vieuxsinge/kegwasher/(threads)

Thread 2 (2019-06-27):

Welldone ! => Peut-on avoir la liste des courses ?

conidelb, 2019-06-27:
Canon les gars ! On va s'en faire une... Hâte d'avoir la liste des courses :-)

fredericsureau, 2019-10-18:
Hello !
Je viens de l'ajouter !
En fait ça nous a coûté moins de 1 500 € HT si on exclut le compresseur
Bon courage à vous

Closed 2019-10-18.

Thread 3 (2019-07-05):

Ajout d’une licence

kdltr, 2019-07-05:
Y’a pas de licence pour la chose ?
Voilà un petit guide sur comment faire, au cas où. :)

https://www.gnu.org/licenses/gpl-howto.fr.html

fredericsureau, 2019-10-18:
C'est fait !
GPLv3 pour info.
Merci du retour

Closed 2019-10-18.

Thread 6 (2020-06-19):

problem with char*

sjavierdu, 2020-06-19:
Hi, I like your project, I bought all parts and try to replicate with some differences: valve 24vdc andtwo types of alimentation: 12vdc(arduino) and 24vdc (valves)

Now I want to take the project to a breadboard but when I try to compile the file these errors appear in kegwasher file:

```
\kegwasher.ino:141:1: warning: ISO C++ forbids converting a string constant to 'char*' [-Wwrite-strings]
 };
 ^
\kegwasher.ino:141:1: warning: ISO C++ forbids converting a string constant to 'char*' [-Wwrite-strings]
\kegwasher.ino:141:1: warning: ISO C++ forbids converting a string constant to 'char*' [-Wwrite-strings]
\kegwasher.ino:141:1: warning: ISO C++ forbids converting a string constant to 'char*' [-Wwrite-strings]
\kegwasher.ino:141:1: warning: ISO C++ forbids converting a string constant to 'char*' [-Wwrite-strings]
\kegwasher.ino:141:1: warning: ISO C++ forbids converting a string constant to 'char*' [-Wwrite-strings]
\kegwasher.ino:141:1: warning: ISO C++ forbids converting a string constant to 'char*' [-Wwrite-strings]
\kegwasher.ino:141:1: warning: ISO C++ forbids converting a string constant to 'char*' [-Wwrite-strings]
\kegwasher.ino:141:1: warning: ISO C++ forbids converting a string constant to 'char*' [-Wwrite-strings]
\kegwasher.ino: In function 'void select()':
\kegwasher.ino:201:22: warning: ISO C++ forbids converting a string constant to 'char*' [-Wwrite-strings]
   lcd_printf("Mode :");
                      ^
\kegwasher.ino:203:53: warning: ISO C++ forbids converting a string constant to 'char*' [-Wwrite-strings]
   lcd_printf("%c %s", CHAR_UP_DOWN, MODES[mode].name);
                                                     ^
\kegwasher.ino: In function 'void select_update()':
\kegwasher.ino:237:55: warning: ISO C++ forbids converting a string constant to 'char*' [-Wwrite-strings]
     lcd_printf("%c %s", CHAR_UP_DOWN, MODES[mode].name);
                                                       ^
\kegwasher.ino: In function 'void run()':
\kegwasher.ino:311:27: warning: ISO C++ forbids converting a string constant to 'char*' [-Wwrite-strings]
   lcd_printf("Preparation");
                           ^
\kegwasher.ino: In function 'void run_update()':
\kegwasher.ino:354:74: warning: ISO C++ forbids converting a string constant to 'char*' [-Wwrite-strings]
   lcd_printf(" %dmn%02d / %dmn%02d", rtime_mn, rtime_s, ftime_mn, ftime_s);
                                                                          ^
\kegwasher.ino: In function 'void terminate()':
\kegwasher.ino:372:24: warning: ISO C++ forbids converting a string constant to 'char*' [-Wwrite-strings]
   lcd_printf(" Termine");
                        ^
\kegwasher.ino: In function 'void cancel()':
\kegwasher.ino:389:23: warning: ISO C++ forbids converting a string constant to 'char*' [-Wwrite-strings]
   lcd_printf(" Annule");
                       ^
El Sketch usa 8512 bytes (26%) del espacio de almacenamiento de programa. El máximo es 32256 bytes.
Las variables Globales usan 768 bytes (37%) de la memoria dinámica, dejando 1280 bytes para las variables locales. El máximo es 2048 bytes.
`

```

`thank` a lot
Javier

sjavierdu, 2020-06-21:
really, no afect the proccess this warning, but the solution is add "const" :

void lcd_printf(const char *fmt, ...)

fredericsureau, 2020-06-23:
Hi sjavierdu,

Thanks for the feedback!
I am using the Arduino environment and I think that nearly all warnings are masked.

Regards

Closed 2020-06-21.

Thread 7 (2020-06-20):

Relai Pompe

blurp1478963, 2020-06-20:
Bonjour,

En étudiant un peu le cablage sur les photos, je ne vois pas de relai pour la pompe, est-elle directement branchée en 220 sur la carte relai ?

Merci!

sjavierdu, 2020-06-22:
Hi, the relay support máx: 10A/250VAC, 10A/30VDC, I think is enough for the pump.
if that pump were higher amperage you would need another relay on the way

sjavierdu, 2020-06-23:
I think channel 9 of the relay is not used for the pump and is replaced by an ssr relay, but @fredericsureau say in other hand that he buy a 16 channel relay for this.

look! this video show as how to add a second contactor (in our case relay) in your relay optocoupler. I believe it not the case: https://www.youtube.com/watch?v=wGYn83sksgE&t=564s
Maybe it helps a little, I didn't know the second ssr relay, I don't see it in the material list (maybe it's a change on the go, )

merci!
merci!

fredericsureau, 2020-06-23:
Oui c'est bien le relai n°9 qui est utilisé directement pour activer la pompe.
Les relais supportent 220VAC/10A ce qui est suffisant pour une petite pompe comme la Novax.

En regardant sur la photo, tu vois un cable marron qui court le long de la carte des relais sur la gauche.
C'est le fil de phase de la pompe.

Bon courage !

fredericsureau, 2020-06-23:
@sjavierdu The SSR relay is used for the heating element. The pump is directly actionned by the relay n° 9.

blurp1478963, 2020-06-23:
Merci! Nous avons presque fini notre laveuse! Nous avons qq input à filer pour contribuer dès qu'elle sera en marche!

Closed 2020-06-23.

Thread 8 (2020-06-21):

remains of peracetic in keg and lack of pressurization

sjavierdu, 2020-06-21:
1- I have found that the program does not leave the keg pressurized at the end of the cycle, this option is correct to avoid foaming when filling due to pressure difference
solution: I have added a washing option in the menu with and without adding co2 for pressurization

2-The peracetic, if used as a desinfectant, is very oxidizing and damages the hop aroma in highly hopped beers, in addition to increasing the level of dissolved oxygen.
solution: A moderately used practice, is after the washing cycle, leave kegs inverted until use the next day, very carefully add it to the kegwasher, do a small purge (it really removes peracetic) and do a new pressurization.

I create the menu in spanish, but only changue the words.
`#include <stdarg.h>
#include <EEPROM.h>
#include <Bounce2.h>
#include <Wire.h>
#include <LiquidCrystal_I2C.h>

#define PIN_BUZZER                A0
#define PIN_BUTTON_UP             A1
#define PIN_BUTTON_DOWN           A2
#define PIN_BUTTON_ACTION         A3
#define PIN_VALVE_AIR             2
#define PIN_VALVE_CO2             3
#define PIN_VALVE_WATER           4
#define PIN_VALVE_CLEANER_IN      5
#define PIN_VALVE_SANITIZER_IN    6
#define PIN_VALVE_CLEANER_OUT     7
#define PIN_VALVE_SANITIZER_OUT   8
#define PIN_VALVE_DRAIN           9
#define PIN_PUMP                  10
#define PIN_LED                   11

#define DISPLAY_I2C_ADDRESS       0x27

#define CTRL_WATER          0b000000001
#define CTRL_CLEANER_IN     0b000000010
#define CTRL_SANITIZER_IN   0b000000100
#define CTRL_AIR            0b000001000
#define CTRL_CO2            0b000010000
#define CTRL_DRAIN          0b000100000
#define CTRL_CLEANER_OUT    0b001000000
#define CTRL_SANITIZER_OUT  0b010000000
#define CTRL_PUMP           0b100000000

#define CONFIG_DRAIN            (CTRL_DRAIN)
#define CONFIG_DRAIN_SANITIZER  (CTRL_PUMP + CTRL_SANITIZER_IN + CTRL_DRAIN)
#define CONFIG_DRAIN_CLEANER    (CTRL_PUMP + CTRL_CLEANER_IN + CTRL_DRAIN)
#define CONFIG_FILL_SANITIZER   (CTRL_PUMP + CTRL_SANITIZER_OUT + CTRL_WATER)
#define CONFIG_FILL_CLEANER     (CTRL_PUMP + CTRL_CLEANER_OUT + CTRL_WATER)
#define CONFIG_RINCE            (CTRL_PUMP + CTRL_WATER + CTRL_DRAIN)
#define CONFIG_RINCE_PURGE      (CTRL_AIR + CTRL_DRAIN)
#define CONFIG_RINCE_PURGE_CO2  (CTRL_CO2 + CTRL_DRAIN)
#define CONFIG_CLEAN            (CTRL_PUMP + CTRL_CLEANER_IN + CTRL_CLEANER_OUT)
#define CONFIG_CLEAN_PURGE      (CTRL_AIR + CTRL_CLEANER_OUT)
#define CONFIG_SANITIZE         (CTRL_PUMP + CTRL_SANITIZER_IN + CTRL_SANITIZER_OUT)
#define CONFIG_SANITIZE_PURGE   (CTRL_AIR + CTRL_SANITIZER_OUT)
#define CONFIG_END              0
#define CONFIG_FILL_CO2         (CTRL_CO2)                     //add
#define LED_BLINK_PERIOD    2

typedef struct step_s {
  unsigned int config;
  int duration;
} step_t;

typedef struct mode_s {
  char *name;
  step_t *steps;
} mode_t;

step_t STEPS_WASH_KEG_CCO2[] = {                    //add  -    con co2 -with co2
  {CONFIG_DRAIN, 10},
  {CONFIG_RINCE, 10},
  {CONFIG_RINCE_PURGE, 20},
  {CONFIG_CLEAN, 10},
  {CONFIG_CLEAN_PURGE, 15},
  {CONFIG_CLEAN, 10},
  {CONFIG_CLEAN_PURGE, 15},
  {CONFIG_CLEAN, 10},
  {CONFIG_CLEAN_PURGE, 20},
  {CONFIG_RINCE, 3},
  {CONFIG_RINCE_PURGE, 10},
  {CONFIG_RINCE, 7},
  {CONFIG_RINCE_PURGE, 10},
  {CONFIG_RINCE, 10},
  {CONFIG_RINCE_PURGE, 20},
  {CONFIG_SANITIZE, 10},
  {CONFIG_SANITIZE_PURGE, 15},
  {CONFIG_SANITIZE, 10},
  {CONFIG_SANITIZE_PURGE, 15},
  {CONFIG_SANITIZE, 10},
  {CONFIG_SANITIZE_PURGE, 20},
  {CONFIG_RINCE, 10},
  {CONFIG_RINCE_PURGE_CO2, 30},
  {CONFIG_FILL_CO2, 10},
  {CONFIG_END, 0}
};

step_t STEPS_WASH_KEG_SCO2[] = {                       //sin co2  - without co2
  {CONFIG_DRAIN, 10},
  {CONFIG_RINCE, 10},
  {CONFIG_RINCE_PURGE, 20},
  {CONFIG_CLEAN, 10},
  {CONFIG_CLEAN_PURGE, 15},
  {CONFIG_CLEAN, 10},
  {CONFIG_CLEAN_PURGE, 15},
  {CONFIG_CLEAN, 10},
  {CONFIG_CLEAN_PURGE, 20},
  {CONFIG_RINCE, 3},
  {CONFIG_RINCE_PURGE, 10},
  {CONFIG_RINCE, 7},
  {CONFIG_RINCE_PURGE, 10},
  {CONFIG_RINCE, 10},
  {CONFIG_RINCE_PURGE, 20},
  {CONFIG_SANITIZE, 10},
  {CONFIG_SANITIZE_PURGE, 15},
  {CONFIG_SANITIZE, 10},
  {CONFIG_SANITIZE_PURGE, 15},
  {CONFIG_SANITIZE, 10},
  {CONFIG_SANITIZE_PURGE, 20},
  {CONFIG_RINCE, 10},
  {CONFIG_RINCE_PURGE_CO2, 30},
    {CONFIG_END, 0}
};

step_t STEPS_DRAFT_RINCE[] = {
  {CONFIG_RINCE, 30},
  {CONFIG_RINCE_PURGE, 10},
  {CONFIG_END, 0}
};

step_t STEPS_DRAFT_SANITIZER[] = {
  {CONFIG_SANITIZE, 30},
  {CONFIG_SANITIZE_PURGE, 10},
  {CONFIG_END, 0}
};

step_t STEPS_DRAFT_CLEANER[] = {
  {CONFIG_CLEAN, 30},
  {CONFIG_CLEAN_PURGE, 10},
  {CONFIG_END, 0}
};

step_t STEPS_DRAIN_KEG[] = {
  {CONFIG_DRAIN, 10},
  {CONFIG_RINCE_PURGE, 60},
  {CONFIG_END, 0}
};

step_t STEPS_DRAIN_SANITIZER[] = {
  {CONFIG_DRAIN_SANITIZER, 120},
  {CONFIG_END, 0}
};

step_t STEPS_DRAIN_CLEANER[] = {
  {CONFIG_DRAIN_CLEANER, 120},
  {CONFIG_END, 0}
};

step_t STEPS_FILL_SANITIZER[] = {
  {CONFIG_FILL_SANITIZER, 120},
  {CONFIG_END, 0}
};

step_t STEPS_FILL_CLEANER[] = {
  {CONFIG_FILL_CLEANER, 120},
  {CONFIG_END, 0}
};

step_t STEPS_ONLY_CO2[] = {                                          //steps add
  {CONFIG_RINCE_PURGE_CO2, 20},
  {CONFIG_FILL_CO2, 10},
  {CONFIG_END, 0}
};

mode_t MODES[] = {
  {"Lavado con CO2", STEPS_WASH_KEG_CCO2},              // add -  con CO2
  {"Lavado sin CO2", STEPS_WASH_KEG_SCO2},               //            sin CO2
  {"Solo enjuague", STEPS_DRAFT_RINCE},
  {"Solo desinfect", STEPS_DRAFT_SANITIZER},
  {"Solo alcalino", STEPS_DRAFT_CLEANER},
  {"Vaciado keg", STEPS_DRAIN_KEG},
  {"Vaciado desinf.", STEPS_DRAIN_SANITIZER},
  {"Vaciado alcal.", STEPS_DRAIN_CLEANER},
  {"Llenado desinf.", STEPS_FILL_SANITIZER},
  {"Llenado alcal.", STEPS_FILL_CLEANER},
  {"Solo CO2",STEPS_ONLY_CO2},                                  //modes add

};

int MODES_NUMBER = sizeof(MODES) / sizeof(mode_t);

Bounce buttonUp = Bounce();
Bounce buttonDown = Bounce();
Bounce buttonAction = Bounce();

LiquidCrystal_I2C lcd(DISPLAY_I2C_ADDRESS, 16, 2);

#define CHAR_UP_DOWN  1
byte CHAR_UP_DOWN_SETUP[] = {
  B00100,
  B01010,
  B10001,
  B00000,
  B00000,
  B10001,
  B01010,
  B00100
};

#define EEPROM_ADDRESS_MODE  0

typedef enum state_e {
  STATE_SELECT,
  STATE_SELECT_UPDATE,
  STATE_RUN,
  STATE_RUN_UPDATE,
  STATE_TERMINATE,
  STATE_CANCEL
} state_t;

state_t state = STATE_SELECT;

int mode = 0;
int mode_start_time;
int mode_full_time;

int step;
int step_start_time;

void lcd_printf(const char *fmt, ...)
{
  char buf1[17];
  va_list args;
  va_start(args, fmt);
  vsnprintf(buf1, sizeof(buf1)-1, fmt, args);
  va_end(args);

  char buf2[17];
  snprintf(buf2, sizeof(buf2)-1, "%-16s", buf1);
  lcd.print(buf2);
}

void select()
{
  lcd.clear();
  lcd.setCursor(0, 0);
  lcd_printf("Mode :");
  lcd.setCursor(0, 1);
  lcd_printf("%c %s", CHAR_UP_DOWN, MODES[mode].name);

  digitalWrite(PIN_LED, HIGH);

  state = STATE_SELECT_UPDATE;
}

void select_update()
{
  int new_mode = mode;
  int inc;

  buttonUp.update();
  if( buttonUp.fell() ) {
    buttonDown.update();
    inc = buttonDown.fell() ? -1 : 1;
    new_mode += inc;
  }

  buttonAction.update();
  if( buttonAction.fell() ) {
    state = STATE_RUN;
  }

  if( new_mode < 0 ) {
    new_mode = MODES_NUMBER - 1;
  }
  else if( new_mode >= MODES_NUMBER ) {
    new_mode = 0;
  }

  if( new_mode != mode ) {
    mode = new_mode;
    lcd.setCursor(0, 1);
    lcd_printf("%c %s", CHAR_UP_DOWN, MODES[mode].name);
  }
}

int seconds()
{
  return millis() / 1000;
}

void controls_set_state(unsigned int config, int state, int delay_time)
{
  if(config & CTRL_AIR) {
    digitalWrite(PIN_VALVE_AIR, state);
    delay(delay_time);
  }
  if(config & CTRL_CO2) {
    digitalWrite(PIN_VALVE_CO2, state);
    delay(delay_time);
  }
  if(config & CTRL_WATER) {
    digitalWrite(PIN_VALVE_WATER, state);
    delay(delay_time);
  }
  if(config & CTRL_CLEANER_IN) {
    digitalWrite(PIN_VALVE_CLEANER_IN, state);
    delay(delay_time);
  }
  if(config & CTRL_SANITIZER_IN) {
    digitalWrite(PIN_VALVE_SANITIZER_IN, state);
    delay(delay_time);
  }
  if(config & CTRL_CLEANER_OUT) {
    digitalWrite(PIN_VALVE_CLEANER_OUT, state);
    delay(delay_time);
  }
  if(config & CTRL_SANITIZER_OUT) {
    digitalWrite(PIN_VALVE_SANITIZER_OUT, state);
    delay(delay_time);
  }
  if(config & CTRL_DRAIN) {
    digitalWrite(PIN_VALVE_DRAIN, state);
    delay(delay_time);
  }
  if(config & CTRL_PUMP) {
    digitalWrite(PIN_PUMP, state);
    delay(delay_time);
  }
}

void controls_set(unsigned int config)
{
  // Turn off all controls to avoid temporary overconsumption
  controls_set_state(~config, HIGH, 0);

  // Turn on all needed controls and wait slowly to avoid temporary overconsumption
  controls_set_state(config, LOW, 200);
}

unsigned int step_set(int index)
{
  step = index;
  step_start_time = seconds();

  controls_set(MODES[mode].steps[step].config);

  return MODES[mode].steps[step].config;
}

void run()
{
  lcd.clear();
  lcd.setCursor(0, 0);
  lcd_printf(MODES[mode].name);
  lcd.setCursor(0, 1);
  lcd_printf("Preparation");

  int saved_mode = EEPROM.read(EEPROM_ADDRESS_MODE);
  if( mode != saved_mode ) {
    EEPROM.write(EEPROM_ADDRESS_MODE, mode);
  }

  mode_start_time = seconds();

  mode_full_time = 0;
  for(int i=0 ; MODES[mode].steps[i].config != CONFIG_END ; i++ ) {
    mode_full_time += MODES[mode].steps[i].duration;
  }

  step_set(0);

  state = STATE_RUN_UPDATE;
}

void run_update()
{
  buttonAction.update();
  if( buttonAction.fell() ) {
    state = STATE_CANCEL;
    return;
  }

  int step_running_time = seconds() - step_start_time;
  if( step_running_time >= MODES[mode].steps[step].duration ) {
    unsigned int config = step_set( step + 1 );
    if( config == CONFIG_END ) {
      state = STATE_TERMINATE;
      return;
    }
  }

  int mode_running_time = seconds() - mode_start_time;
  int rtime_mn = mode_running_time / 60;
  int rtime_s = mode_running_time % 60;
  int ftime_mn = mode_full_time / 60;
  int ftime_s = mode_full_time % 60;

  lcd.setCursor(0, 1);
  lcd_printf(" %dmn%02d / %dmn%02d", rtime_mn, rtime_s, ftime_mn, ftime_s);

  if( mode_running_time % LED_BLINK_PERIOD < LED_BLINK_PERIOD/2 ) {
    digitalWrite(PIN_LED, HIGH);
  }
  else {
    digitalWrite(PIN_LED, LOW);
  }

}

void terminate()
{
  controls_set(0);

  digitalWrite(PIN_LED, LOW);

  lcd.setCursor(0, 1);
  lcd_printf(" Termine");

  for( int i=0 ; i<3 ; i++ ) {
    tone(PIN_BUZZER, 1760, 800);
    delay(1000);
  }

  state = STATE_SELECT;
}

void cancel()
{
  controls_set(0);

  digitalWrite(PIN_LED, LOW);

  lcd.setCursor(0, 1);
  lcd_printf(" Annule");

  tone(PIN_BUZZER, 1760, 800);
  delay(1000);

  state = STATE_SELECT;
}

void setup()
{
  pinMode(PIN_BUTTON_UP, INPUT_PULLUP);
  pinMode(PIN_BUTTON_DOWN, INPUT_PULLUP);
  pinMode(PIN_BUTTON_ACTION, INPUT_PULLUP);
  pinMode(PIN_VALVE_AIR, OUTPUT);
  pinMode(PIN_VALVE_CO2, OUTPUT);
  pinMode(PIN_VALVE_WATER, OUTPUT);
  pinMode(PIN_VALVE_CLEANER_IN, OUTPUT);
  pinMode(PIN_VALVE_SANITIZER_IN, OUTPUT);
  pinMode(PIN_VALVE_CLEANER_OUT, OUTPUT);
  pinMode(PIN_VALVE_SANITIZER_OUT, OUTPUT);
  pinMode(PIN_VALVE_DRAIN, OUTPUT);
  pinMode(PIN_LED, OUTPUT);
  pinMode(PIN_PUMP, OUTPUT);
  pinMode(PIN_BUZZER, OUTPUT);

  controls_set(0);
  digitalWrite(PIN_LED, LOW);
  digitalWrite(PIN_BUZZER, LOW);

  buttonUp.attach(PIN_BUTTON_UP);
  buttonDown.attach(PIN_BUTTON_DOWN);
  buttonAction.attach(PIN_BUTTON_ACTION);

  buttonUp.interval(10);
  buttonDown.interval(10);
  buttonAction.interval(10);

  lcd.begin();
  lcd.setBacklight(HIGH);
  lcd.createChar(CHAR_UP_DOWN, CHAR_UP_DOWN_SETUP);

  mode = EEPROM.read(EEPROM_ADDRESS_MODE);
  mode = constrain(mode, 0, MODES_NUMBER - 1);
}

void loop()
{
  switch(state) {
    case STATE_SELECT:
      select();
      break;
    case STATE_SELECT_UPDATE:
      select_update();
      break;
    case STATE_RUN:
      run();
      break;
    case STATE_RUN_UPDATE:
      run_update();
      break;
    case STATE_TERMINATE:
      terminate();
      break;
    case STATE_CANCEL:
      cancel();
      break;
  }
}`

I'd just like to increase the delay from the co2 purge to the pressurized, I didn't find the how
good luck!!!

fredericsureau, 2020-06-23:
Hi @sjavierdu !

1/ This feature was implemented in the first version, but the plumbing was not supporting the pressure very well. After multiple uses, some leaks appeared. In the end, we finally went with a simple CO2 flush and pressurization is done just before filling the keg. Anyway, if you go this way, be sure to limit your CO2 pressure entry and you may have to add a check valve for each keg to avoid CO2 to flow back when removing kegs.

2/ There is a rinse step using water after the peracetic desinfection to avoid direct contact with peracetic (not allowed in France) and the CO2 flush should remove most of the remaining liquid in the keg. We are filling kegs just after cleaning with the washer and we don't have oxidation issues even for hoppy beers. If this is really a problem, I would rather go with a desinfection using steam : not ready to wait 1 day between cleaning and filling ;)

BTW, please send PR rather than copying the whole code in the comment section. This will be much more readable.

Closed 2020-06-22.

Thread 10 (2022-04-26):

Relais Pompe ?

frouault35, 2022-04-26:
Bonjour à vous!
et tout d'abord merci à vous, je suis sur le point de monter cet engin, et aussi de l'adapter pour aussi laver des fermenteurs. (je pense qu'avec un nouveau mode + des vannes manuelles avec té je peux m'en sortir).
Tout me parait plutôt clair mais j'ai une question concernant l'alimentation de la pompe...
Il semblerait que vous l'alimentiez en 12V à partir de la carte 16 relais du coup ? comme les électrovannes... normal pour une pompe Novax ? ou j'ai du louper quelque chose?
Merci de me répondre si vous passez par là!

fredericsureau, 2022-04-26:
Salut à toi,

La carte 16 relais est bien alimentée en 12VDC pour faire fonctionner les relais.
La pompe Novax est alimentée en 230VAC, le relais fait seulement la coupure (et c'est le même principe pour les électrovannes même si elles sont reliées à la même alim 12VDC que la carte relais)

Je t'invite à regarder le fonctionnement des relais avant le montage électrique, histoire d'éviter de cramer des composants ;)

Bon courage pour le montage
Fred

frouault35, 2022-04-26:
Ah je comprends mieux ;) , je pensais pas qu'on pouvait lui faire passer du 230v, sans justement la faire cramer, je vais regarder la doc des cartes relais, ca serait dommage de tout bruler !
En tout cas Merci pour le partage, vous gérez! on mettra une petite photo quand on aura fini!

Closed 2022-04-26.

Thread 11 (2022-08-23):

Caractéristiques pompe et passage en 4 futs

ericdaunay, 2022-08-23:
Salut,
Merci pour ce partage !
Je vais fabriquer cette machine et j'aurais quelques questions :
- tu dis que la NOVAX 20B est un peu juste et que vous en avez mis une plus puissante. Tu pourrais m'indiquer le modèle ?
- avez vous déjà pensé/testé, le passage à 4 futs au lieu de 2 ? Penses tu que c'est faisable avec une pompe plus puissante ? Ou bien cela demande trop de modifs (volume réservoirs et/ou diamètre tuyauteries en particulier)
Merci !
Eric
