vieuxsinge/kegwasher/(commit log)

2019-02-19 Ajout de documentation
2019-02-19 Ajout de vidéos
2019-02-19 Restructuration de la doc
2019-07-31 Ajout de quelques liens
2019-10-18 Liste des composants et prix
2019-10-18 Mise en forme liste des composants
2019-10-18 Texte avant tableau des prix
2019-10-18 Ajout de la licence
2020-01-27 Add Github link for library
    FRENCH bellow
    Add link for the LiquidCrystal_I2C library, because she not availaible/or difficult to find it in the Ardunio interface.
    French
    Ajout du lien de la bibliothèque LiquidCrystal_I2C, car elle n'est pas disponibles/ ou difficile à trouver dans l'interface Ardunio.
2021-01-12 Change LiquidCrystal_I2C library for a newer one. Fix #4
    [kegwasher.ino]
2021-01-12 Fix menu selector using rotary encoder
    [kegwasher.ino]
